YakimV/Touchless-Washbasin-Sensors/hlk-ld2416/schematic.png

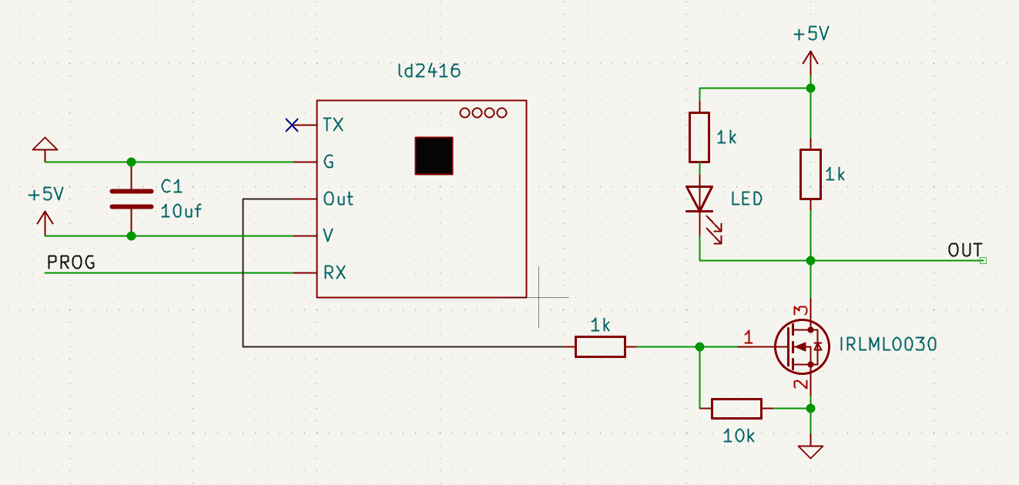
hlk-ld2416/schematic.png
