YakimV/Touchless-Washbasin-Sensors/hlk_ld1020-ch32v003/schematic.png

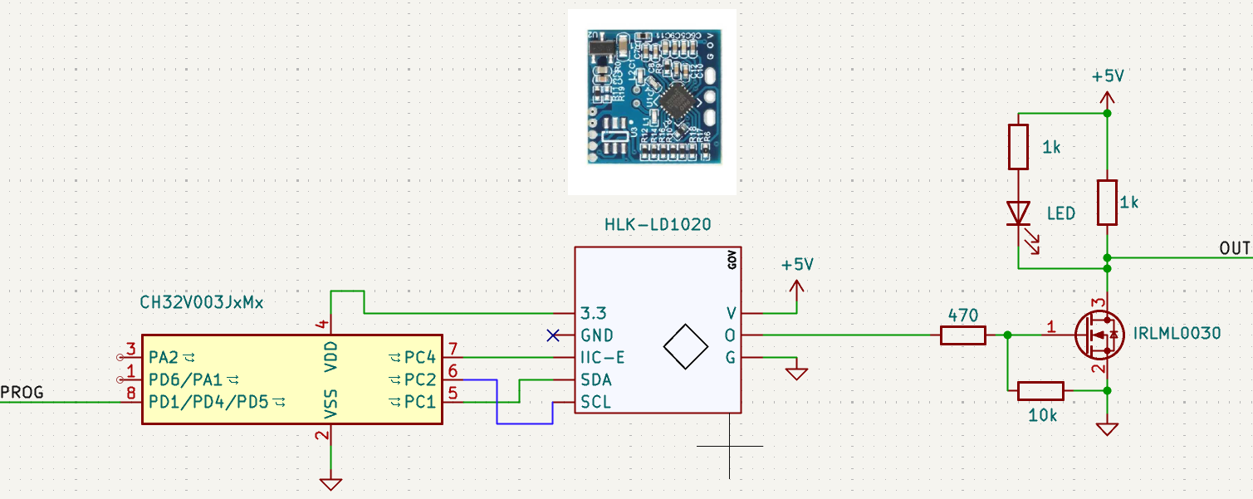
hlk_ld1020-ch32v003/schematic.png
