YakimV/Touchless-Washbasin-Sensors/hlk-ld2416/KiCad files/sensorUmivalnik.kicad_pcb

## KiCad design hlk-ld2416/KiCad files/sensorUmivalnik.kicad_pcb (2026-10-17)

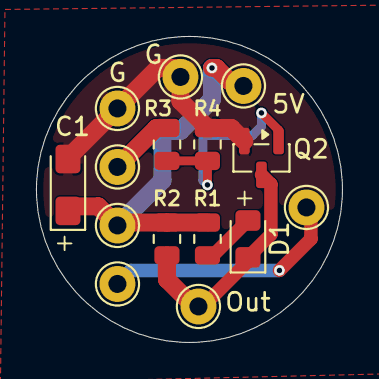
[picture p4: board sensorUmivalnik.kicad_pcb from above]

Board: 2 copper layers, 17.0 x 17.0 mm, 15 parts (0 on the bottom side), 7 nets.

Parts:
5V, 5V#2: Conn_01x01_Pin; TestPoint_THTPad_D2.0mm_Drill1.0mm
C1: 47uf; CP_EIA-3216-18_Kemet-A_HandSolder
D1: LED; LED_0805_2012Metric_Pad1.15x1.40mm_HandSolder
G: Conn_01x01_Pin; TestPoint_THTPad_D2.0mm_Drill1.0mm
G#2: Conn_01x01_Pin; TestPoint_THTPad_D2.0mm_Drill1.0mm
Out: Conn_01x01_Pin; TestPoint_THTPad_D2.0mm_Drill1.0mm
Outraw: Conn_01x01_Pin; TestPoint_THTPad_D2.0mm_Drill1.0mm
PROG: Conn_01x01_Pin; TestPoint_THTPad_D2.0mm_Drill1.0mm
PROG#2: Conn_01x01_Pin; TestPoint_THTPad_D2.0mm_Drill1.0mm
Q2: IRLML0030; SOT-23
R1, R2, R3: 1k; R_0805_2012Metric
R4: 10k; R_0805_2012Metric

Connections:
+5V: 5V.1 (Pin_1_1), 5V#2.1 (Pin_1_1), C1.1, R1.1, R2.1
/OUT: D1.1 (K), Out.1 (Pin_1_1), Q2.3 (D), R2.2
/PROG: PROG.1 (Pin_1_1), PROG#2.1 (Pin_1_1)
GND: C1.2, G.1 (Pin_1_1), G#2.1 (Pin_1_1), Q2.2 (S), R4.2
unnamed: D1.2 (A), R1.2
unnamed: Outraw.1 (Pin_1_1), R3.1
unnamed: Q2.1 (G), R3.2, R4.1
