YakimV/Touchless-Washbasin-Sensors/(commit log)

2026-09-02 Add sensor configuration script for radar detection
    This script configures a radar sensor with parameters for detection distance, absence delay, motion sensitivity, and mounting type. It sends the configuration to the sensor via a serial connection.
2026-09-02 Rename Screenshot from 2026-09-02 13-38-10.png to schematic.png
2026-09-05 Add VL53L0X distance sensor functionality
2026-09-05 Add initial implementation of distance sensor control
2026-09-05 Enhance README with sensor comparisons and experiences
    Added detailed information about sensor options and personal experiences with them, including a special mention of the RCWL-0516's failures and the CH32V003 microcontroller.
2026-09-05 Update README with LD2416 sensor information
    Added section about LD2416-based sensor with link.
2026-09-05 Update README with LD2416 sensor information
    Add section for LD2416-based sensor with link.
